augustbering/besc-hw/design/BLDC_4.kicad_pcb

## KiCad design design/BLDC_4.kicad_pcb (2025-11-01)

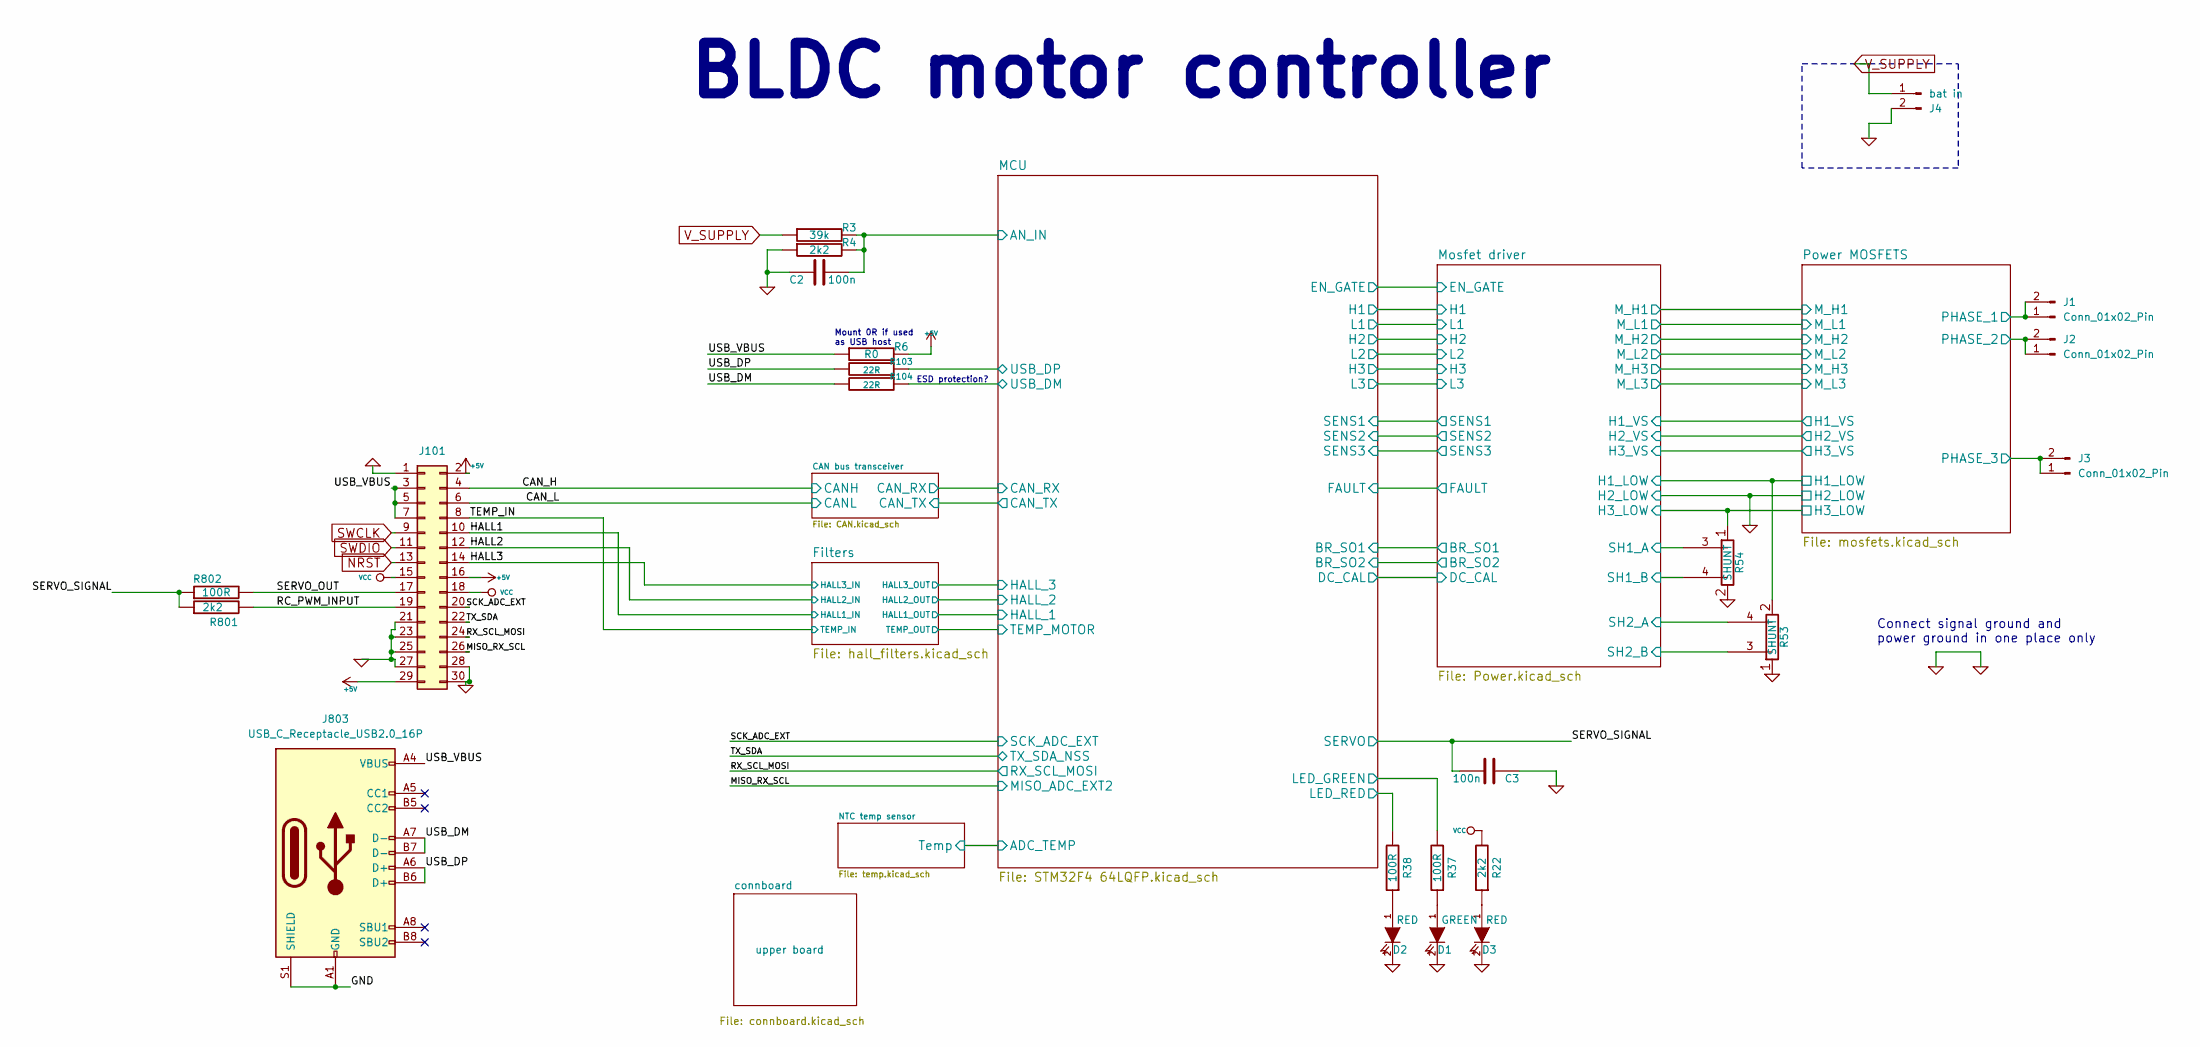
[picture p1: schematic BLDC_4.kicad_sch, BLDC Driver]

Parts:
C2, C3: 100n; SMD-0603_c
D1: GREEN; LED-0603; JLCPCB C19273151
D2, D3: RED; LED-0603
J1, J2, J3: Conn_01x02_Pin; AMASS_XT60-F_1x02_P7.20mm_Vertical; JLCPCB C98734
J4: bat in; xt-90 vertical; JLCPCB C3040688
J101: Conn_02x16_Odd_Even; PinHeader_2x15_P2.54mm_Vertical; JLCPCB C169817
J803: USB_C_Receptacle_USB2.0_16P; USB_C_Receptacle_GCT_USB4115-03-C; JLCPCB C183608
R3: 39k; SMD-0603_r
R4, R22, R801: 2k2; SMD-0603_r
R6: R0; SMD-0603_r; JLCPCB C21189
R37, R38, R802: 100R; SMD-0603_r
R53, R54: SHUNT; WSLP2726; JLCPCB C500635
R103, R104: 22R; SMD-0603_r

Connections:
+5V: J101.2, J101.16, J101.29, R6.2; also elsewhere on the board
/CAN_H: J101.4; also elsewhere on the board
/CAN_L: J101.6; also elsewhere on the board
/HALL1: J101.10; also elsewhere on the board
/HALL2: J101.12; also elsewhere on the board
/HALL3: J101.14; also elsewhere on the board
/MCU/AN_IN: C2.2, R3.2, R4.2; also elsewhere on the board
/MCU/LED_GREEN: R37.2; also elsewhere on the board
/MCU/LED_RED: R38.2; also elsewhere on the board
/MCU/USB_DM: R104.1; also elsewhere on the board
/MCU/USB_DP: R103.1; also elsewhere on the board
/MISO_RX_SCL: J101.26; also elsewhere on the board
/Mosfet driver/H1_LOW: R53.2; also elsewhere on the board
/Mosfet driver/H1_VS: J1.1, J1.2; also elsewhere on the board
/Mosfet driver/H2_VS: J2.1, J2.2; also elsewhere on the board
/Mosfet driver/H3_LOW: R54.1; also elsewhere on the board
/Mosfet driver/H3_VS: J3.1, J3.2; also elsewhere on the board
/Mosfet driver/SH1_A: R54.3; also elsewhere on the board
/Mosfet driver/SH1_B: R54.4; also elsewhere on the board
/Mosfet driver/SH2_A: R53.4; also elsewhere on the board
/Mosfet driver/SH2_B: R53.3; also elsewhere on the board
/RC_PWM_INPUT: J101.19, R801.2
/RX_SCL_MOSI: J101.24; also elsewhere on the board
/SCK_ADC_EXT: J101.20; also elsewhere on the board
/SERVO_OUT: J101.17, R802.2
/SERVO_SIGNAL: C3.2, R801.1, R802.1; also elsewhere on the board
/TEMP_IN: J101.8; also elsewhere on the board
/TX_SDA: J101.22; also elsewhere on the board
/USB_DM: J803.A7 (D-), J803.B7 (D-), R104.2
/USB_DP: J803.A6 (D+), J803.B6 (D+), R103.2
/USB_VBUS: J101.3, J101.5, J101.7, J803.A4 (VBUS), J803.A9 (VBUS), J803.B4 (VBUS), J803.B9 (VBUS), R6.1
GND: C2.1, C3.1, D1.2 (K), D2.2 (K), D3.2 (K), J4.2, J101.1, J101.21, J101.23, J101.25, J101.27, J101.28, J101.30, J803.A1 (GND), J803.A12 (GND), J803.B1 (GND), J803.B12 (GND), J803.S1 (SHIELD), R4.1, R53.1, R54.2; also elsewhere on the board
NRST: J101.13; also elsewhere on the board
unnamed: D1.1 (A), R37.1
unnamed: D2.1 (A), R38.1
unnamed: D3.1 (A), R22.1
SWCLK: J101.9; also elsewhere on the board
SWDIO: J101.11; also elsewhere on the board
VCC: J101.15, J101.18, R22.2; also elsewhere on the board
V_SUPPLY: J4.1, R3.1; also elsewhere on the board

Notes on the sheet:
BLDC motor controller
ESD protection?
Mount 0R if used as USB host
Connect signal ground and power ground in one place only

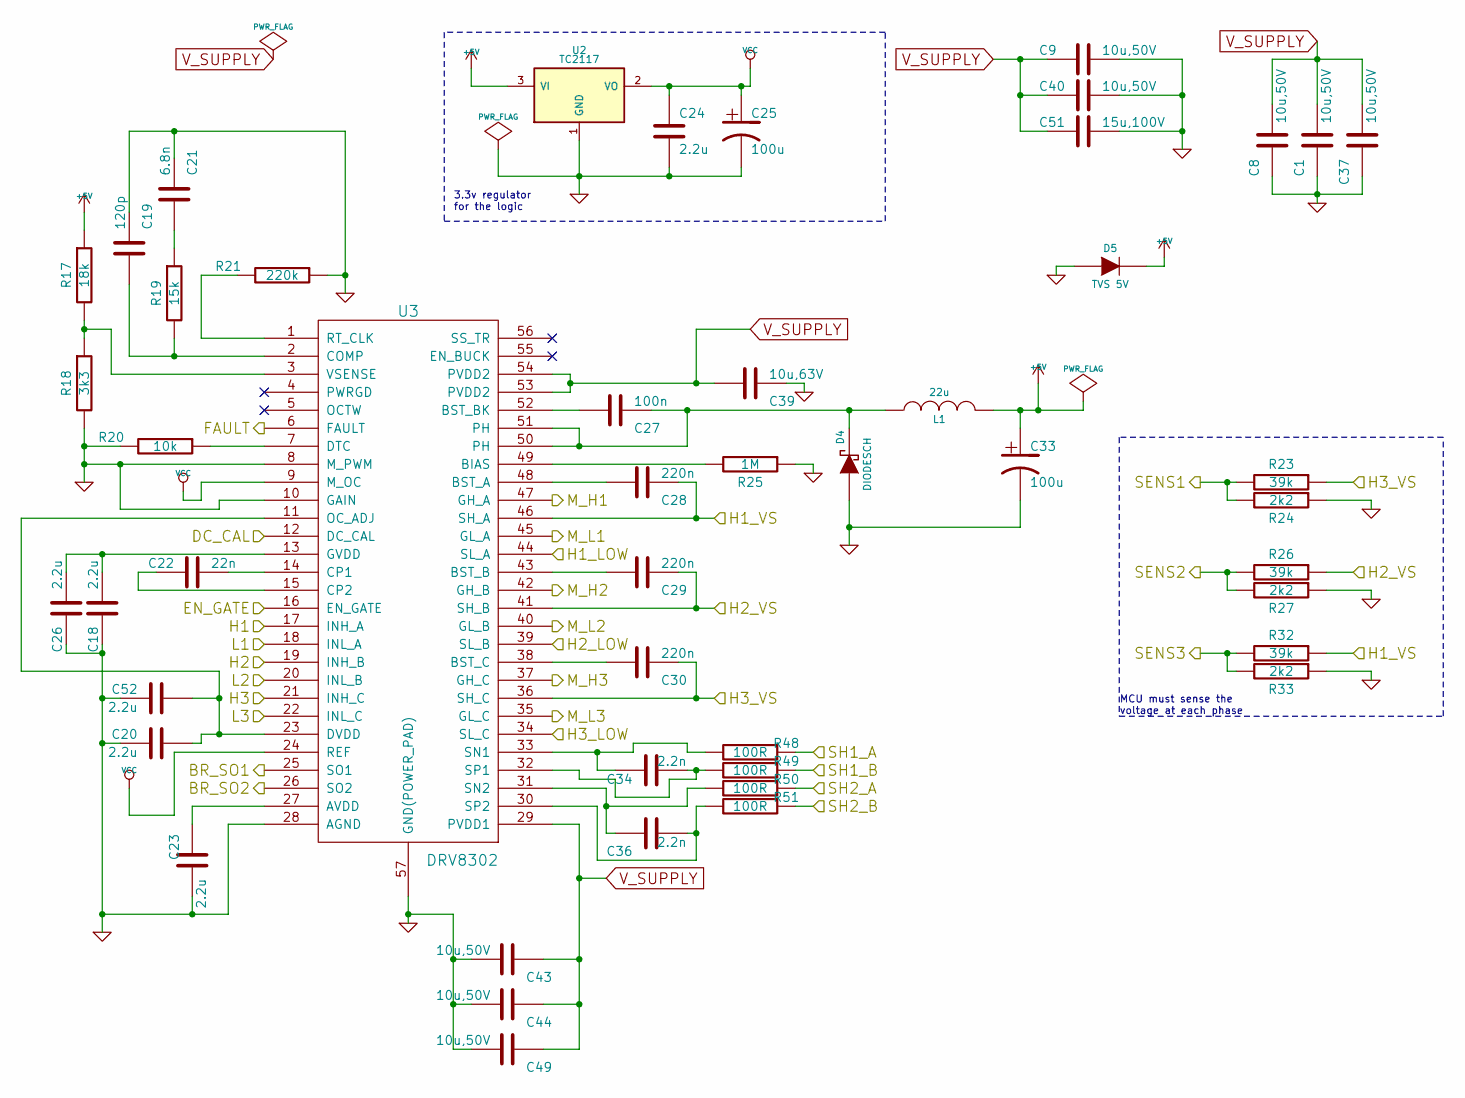
[picture p2: schematic Power.kicad_sch, BLDC Driver 4.11]

Parts:
C1, C8, C9, C37, C40, C43, C44, C49: 10u,50V; SMD-1206; JLCPCB C13585
C18, C20, C23, C24, C26, C52: 2.2u; SMD-0603_c; JLCPCB C23630
C19: 120p; SMD-0603_c
C21: 6.8n; SMD-0603_c
C22: 22n; SMD-0603_c
C25, C33: 100u; c_tant_B; JLCPCB C116740
C27: 100n; SMD-0603_c
C28, C29, C30: 220n; SMD-0603_c
C34, C36: 2.2n; SMD-0603_c
C39: 10u,63V; SMD-1206
C51: 15u,100V; c_2220; JLCPCB C5795620
D4: DIODESCH; SMA_Handsoldering; JLCPCB C6807782
D5: TVS 5V; do214ac; JLCPCB C2760868
L1: 22u; inductor_smd_8x5mm; JLCPCB C139488
R17: 18k; SMD-0603_r
R18: 3k3; SMD-0603_r
R19: 15k; SMD-0603_r
R20: 10k; SMD-0603_r
R21: 220k; SMD-0603_r
R23, R26, R32: 39k; SMD-0603_r
R24, R27, R33: 2k2; SMD-0603_r
R25: 1M; SMD-0603_r
R48, R49, R50, R51: 100R; SMD-0603_r
U2: TC2117; SOT-223; JLCPCB C98655
U3: DRV8302; TSSOP-56-PP; JLCPCB C79740

Connections:
+5V: C33.1, D5.2 (K), L1.2, R17.1, U2.3 (VI); also elsewhere on the board
/MCU/BR_SO1: U3.25 (SO1); also elsewhere on the board
/MCU/BR_SO2: U3.26 (SO2); also elsewhere on the board
/MCU/DC_CAL: U3.12 (DC_CAL); also elsewhere on the board
/MCU/EN_GATE: U3.16 (EN_GATE); also elsewhere on the board
/MCU/FAULT: U3.6 (FAULT); also elsewhere on the board
/MCU/H1: U3.17 (INH_A); also elsewhere on the board
/MCU/H2: U3.19 (INH_B); also elsewhere on the board
/MCU/H3: U3.21 (INH_C); also elsewhere on the board
/MCU/L1: U3.18 (INL_A); also elsewhere on the board
/MCU/L2: U3.20 (INL_B); also elsewhere on the board
/MCU/L3: U3.22 (INL_C); also elsewhere on the board
/MCU/SENS1: R23.2, R24.2; also elsewhere on the board
/MCU/SENS2: R26.2, R27.2; also elsewhere on the board
/MCU/SENS3: R32.2, R33.2; also elsewhere on the board
/Mosfet driver/H1_LOW: U3.44 (SL_A); also elsewhere on the board
/Mosfet driver/H1_VS: C28.1, R32.1, U3.46 (SH_A); also elsewhere on the board
/Mosfet driver/H2_VS: C29.1, R26.1, U3.41 (SH_B); also elsewhere on the board
/Mosfet driver/H3_LOW: U3.34 (SL_C); also elsewhere on the board
/Mosfet driver/H3_VS: C30.1, R23.1, U3.36 (SH_C); also elsewhere on the board
/Mosfet driver/M_H1: U3.47 (GH_A); also elsewhere on the board
/Mosfet driver/M_H2: U3.42 (GH_B); also elsewhere on the board
/Mosfet driver/M_H3: U3.37 (GH_C); also elsewhere on the board
/Mosfet driver/M_L1: U3.45 (GL_A); also elsewhere on the board
/Mosfet driver/M_L2: U3.40 (GL_B); also elsewhere on the board
/Mosfet driver/M_L3: U3.35 (GL_C); also elsewhere on the board
/Mosfet driver/SH1_A: R48.1; also elsewhere on the board
/Mosfet driver/SH1_B: R49.1; also elsewhere on the board
/Mosfet driver/SH2_A: R50.1; also elsewhere on the board
/Mosfet driver/SH2_B: R51.1; also elsewhere on the board
GND: C1.1, C8.1, C9.1, C18.2, C19.1, C20.1, C21.1, C23.1, C24.2, C25.2, C26.2, C33.2, C37.1, C39.1, C40.1, C43.2, C44.2, C49.2, C51.1, C52.1, D4.1 (A), D5.1 (A), R18.2, R20.2, R21.1, R24.1, R25.1, R27.1, R33.1, U2.1 (GND), U3.8 (M_PWM), U3.10 (GAIN), U3.28 (AGND), U3.39 (SL_B), U3.57 (GND(POWER_PAD)); also elsewhere on the board
unnamed: C21.2, R19.1
unnamed: C27.1, D4.2 (K), L1.1, U3.50 (PH), U3.51 (PH)
unnamed: C23.2, U3.27 (AVDD)
unnamed: R25.2, U3.49 (BIAS)
unnamed: C28.2, U3.48 (BST_A)
unnamed: C29.2, U3.43 (BST_B)
unnamed: C27.2, U3.52 (BST_BK)
unnamed: C30.2, U3.38 (BST_C)
unnamed: C19.2, R19.2, U3.2 (COMP)
unnamed: C22.1, U3.14 (CP1)
unnamed: C22.2, U3.15 (CP2)
unnamed: R20.1, U3.7 (DTC)
unnamed: C20.2, C52.2, U3.11 (OC_ADJ), U3.23 (DVDD)
unnamed: C18.1, C26.1, U3.13 (GVDD)
unnamed: R21.2, U3.1 (RT_CLK)
unnamed: C34.1, R48.2, U3.33 (SN1)
unnamed: C36.1, R50.2, U3.31 (SN2)
unnamed: C34.2, R49.2, U3.32 (SP1)
unnamed: C36.2, R51.2, U3.30 (SP2)
unnamed: R17.2, R18.1, U3.3 (VSENSE)
VCC: C24.1, C25.1, U2.2 (VO), U3.9 (M_OC), U3.24 (REF); also elsewhere on the board
V_SUPPLY: C1.2, C8.2, C9.2, C37.2, C39.2, C40.2, C43.1, C44.1, C49.1, C51.2, U3.29 (PVDD1), U3.53 (PVDD2), U3.54 (PVDD2); also elsewhere on the board

Notes on the sheet:
MCU must sense the voltage at each phase
3.3v regulator for the logic

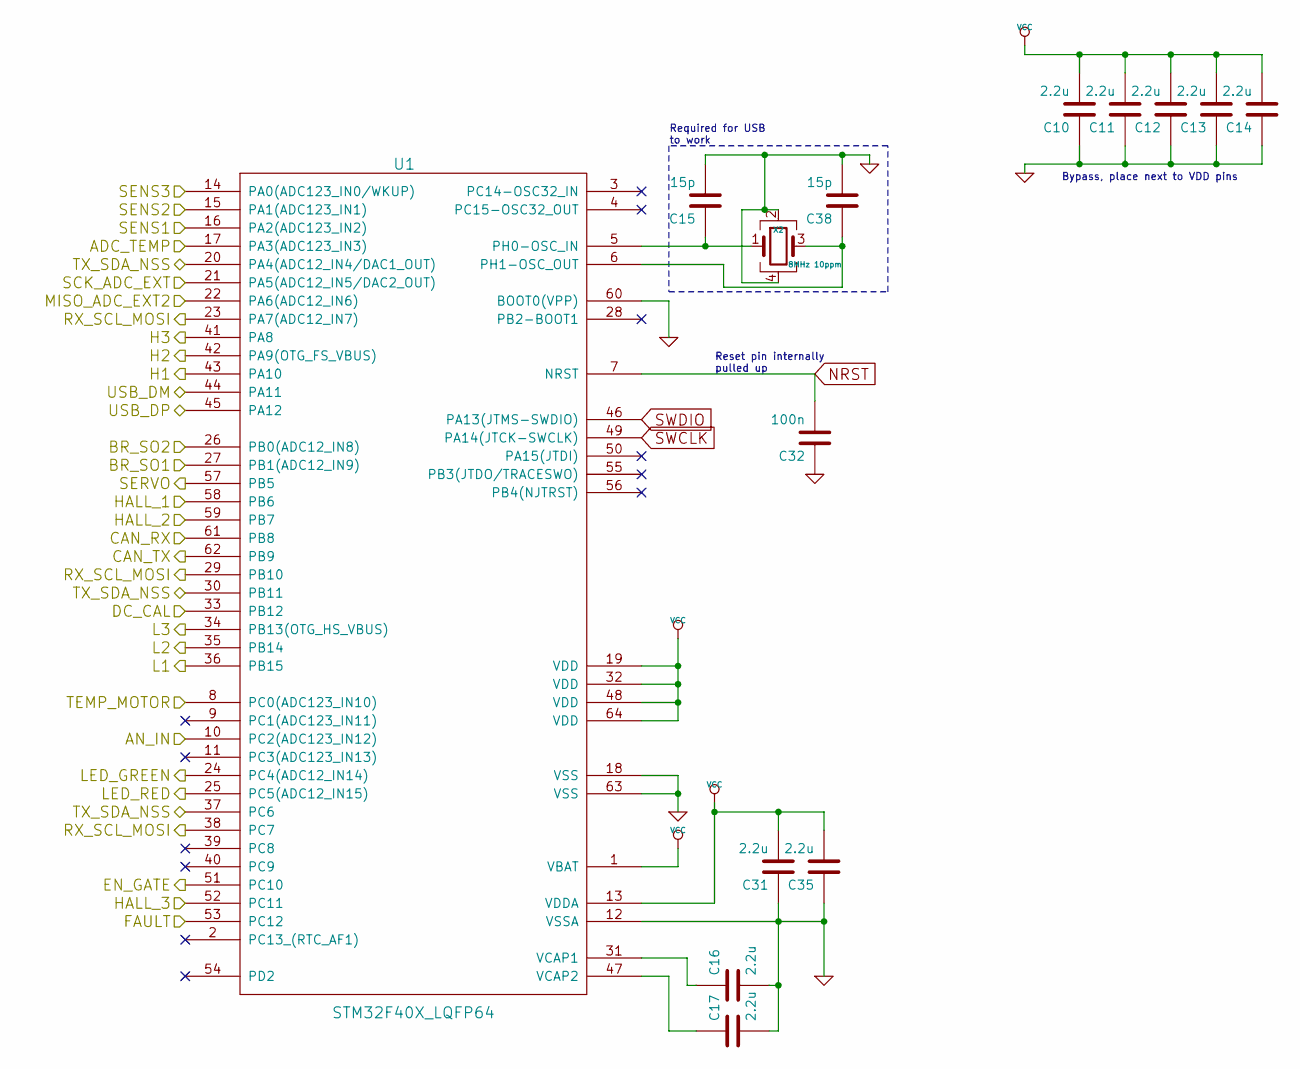
[picture p3: schematic STM32F4 64LQFP.kicad_sch, BLDC Driver 4.11]

Parts:
C10, C11, C12, C13, C14, C16, C17, C31, C35: 2.2u; SMD-0603_c; JLCPCB C23630
C15, C38: 15p; SMD-0603_c
C32: 100n; SMD-0603_c
U1: STM32F40X_LQFP64; lqfp64_pad_mod; JLCPCB C15742
X2: 8MHz 10ppm; Crystal_SMD_3225-4Pin_3.2x2.5mm; JLCPCB C5308002

Connections:
/CAN bus transceiver/CAN_RX: U1.61 (PB8); also elsewhere on the board
/CAN bus transceiver/CAN_TX: U1.62 (PB9); also elsewhere on the board
/Filters/HALL1_OUT: U1.58 (PB6); also elsewhere on the board
/Filters/HALL2_OUT: U1.59 (PB7); also elsewhere on the board
/Filters/HALL3_OUT: U1.52 (PC11); also elsewhere on the board
/MCU/ADC_TEMP: U1.17 (PA3(ADC123_IN3)); also elsewhere on the board
/MCU/AN_IN: U1.10 (PC2(ADC123_IN12)); also elsewhere on the board
/MCU/BR_SO1: U1.27 (PB1(ADC12_IN9)); also elsewhere on the board
/MCU/BR_SO2: U1.26 (PB0(ADC12_IN8)); also elsewhere on the board
/MCU/DC_CAL: U1.33 (PB12); also elsewhere on the board
/MCU/EN_GATE: U1.51 (PC10); also elsewhere on the board
/MCU/FAULT: U1.53 (PC12); also elsewhere on the board
/MCU/H1: U1.43 (PA10); also elsewhere on the board
/MCU/H2: U1.42 (PA9(OTG_FS_VBUS)); also elsewhere on the board
/MCU/H3: U1.41 (PA8); also elsewhere on the board
/MCU/L1: U1.36 (PB15); also elsewhere on the board
/MCU/L2: U1.35 (PB14); also elsewhere on the board
/MCU/L3: U1.34 (PB13(OTG_HS_VBUS)); also elsewhere on the board
/MCU/LED_GREEN: U1.24 (PC4(ADC12_IN14)); also elsewhere on the board
/MCU/LED_RED: U1.25 (PC5(ADC12_IN15)); also elsewhere on the board
/MCU/SENS1: U1.16 (PA2(ADC123_IN2)); also elsewhere on the board
/MCU/SENS2: U1.15 (PA1(ADC123_IN1)); also elsewhere on the board
/MCU/SENS3: U1.14 (PA0(ADC123_IN0/WKUP)); also elsewhere on the board
/MCU/USB_DM: U1.44 (PA11); also elsewhere on the board
/MCU/USB_DP: U1.45 (PA12); also elsewhere on the board
/MISO_RX_SCL: U1.22 (PA6(ADC12_IN6)); also elsewhere on the board
/RX_SCL_MOSI: U1.23 (PA7(ADC12_IN7)), U1.29 (PB10), U1.38 (PC7); also elsewhere on the board
/SCK_ADC_EXT: U1.21 (PA5(ADC12_IN5/DAC2_OUT)); also elsewhere on the board
/SERVO_SIGNAL: U1.57 (PB5); also elsewhere on the board
/TEMP_IN: U1.8 (PC0(ADC123_IN10)); also elsewhere on the board
/TX_SDA: U1.20 (PA4(ADC12_IN4/DAC1_OUT)), U1.30 (PB11), U1.37 (PC6); also elsewhere on the board
GND: C10.1, C11.1, C12.1, C13.1, C14.1, C15.2, C16.2, C17.2, C31.1, C32.1, C35.1, C38.2, U1.12 (VSSA), U1.18 (VSS), U1.60 (BOOT0(VPP)), U1.63 (VSS), X2.2, X2.4; also elsewhere on the board
NRST: C32.2, U1.7 (NRST); also elsewhere on the board
unnamed: C15.1, U1.5 (PH0-OSC_IN), X2.1
unnamed: C38.1, U1.6 (PH1-OSC_OUT), X2.3
unnamed: C16.1, U1.31 (VCAP1)
unnamed: C17.1, U1.47 (VCAP2)
SWCLK: U1.49 (PA14(JTCK-SWCLK)); also elsewhere on the board
SWDIO: U1.46 (PA13(JTMS-SWDIO)); also elsewhere on the board
VCC: C10.2, C11.2, C12.2, C13.2, C14.2, C31.2, C35.2, U1.1 (VBAT), U1.13 (VDDA), U1.19 (VDD), U1.32 (VDD), U1.48 (VDD), U1.64 (VDD); also elsewhere on the board

Notes on the sheet:
Reset pin internally pulled up
Bypass, place next to VDD pins
Required for USB to work

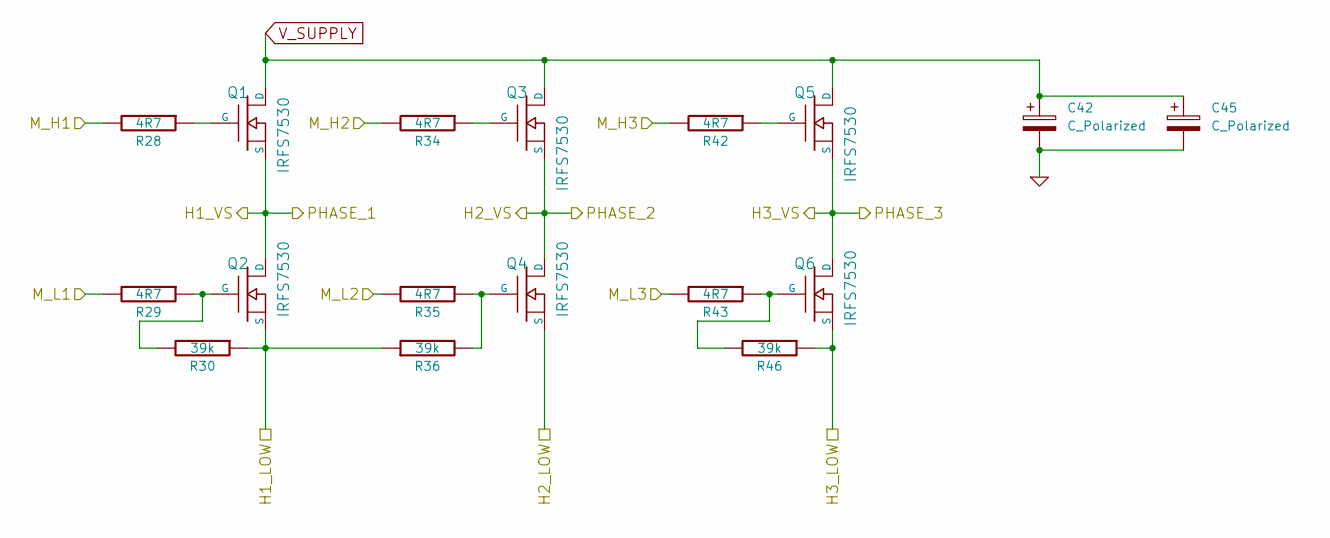
[picture p4: schematic mosfets.kicad_sch, BLDC Driver 4.11]

Parts:
C42, C45: C_Polarized; CP_Radial_D13.0mm_P5.00mm; JLCPCB c106632
Q1, Q2, Q3, Q4, Q5, Q6: IRFS7530; D2PAK-7-GDS; JLCPCB C445669
R28, R29, R34, R35, R42, R43: 4R7; SMD-0603_r
R30, R36, R46: 39k; SMD-0603_r

Connections:
/Mosfet driver/H1_LOW: Q2.S, R30.1, R36.1; also elsewhere on the board
/Mosfet driver/H1_VS: Q1.S, Q2.D; also elsewhere on the board
/Mosfet driver/H2_VS: Q3.S, Q4.D; also elsewhere on the board
/Mosfet driver/H3_LOW: Q6.S, R46.1; also elsewhere on the board
/Mosfet driver/H3_VS: Q5.S, Q6.D; also elsewhere on the board
/Mosfet driver/M_H1: R28.2; also elsewhere on the board
/Mosfet driver/M_H2: R34.2; also elsewhere on the board
/Mosfet driver/M_H3: R42.2; also elsewhere on the board
/Mosfet driver/M_L1: R29.2; also elsewhere on the board
/Mosfet driver/M_L2: R35.2; also elsewhere on the board
/Mosfet driver/M_L3: R43.2; also elsewhere on the board
GND: C42.2, C45.2, Q4.S; also elsewhere on the board
unnamed: Q1.G, R28.1
unnamed: Q2.G, R29.1, R30.2
unnamed: Q3.G, R34.1
unnamed: Q4.G, R35.1, R36.2
unnamed: Q5.G, R42.1
unnamed: Q6.G, R43.1, R46.2
V_SUPPLY: C42.1, C45.1, Q1.D, Q3.D, Q5.D; also elsewhere on the board

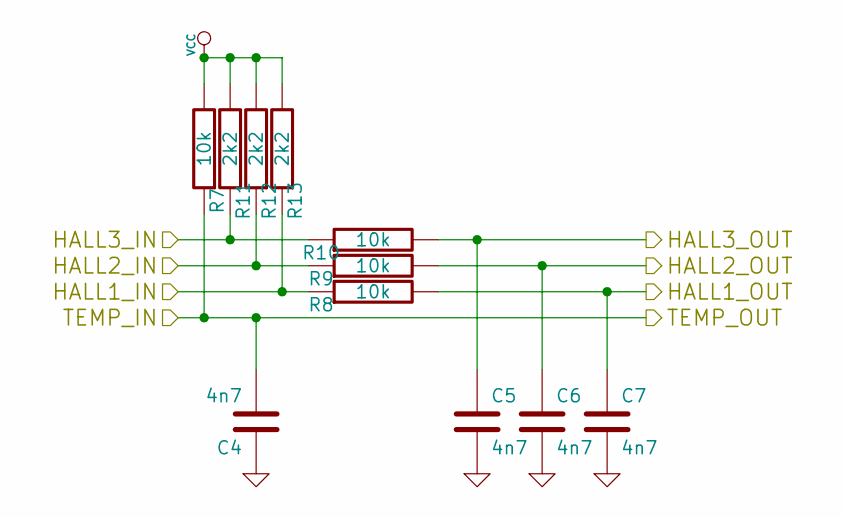
[picture p5: schematic hall_filters.kicad_sch, BLDC Driver 4.11]

Parts:
C4, C5, C6, C7: 4n7; SMD-0603_c; JLCPCB C53987
R7, R8, R9, R10: 10k; SMD-0603_r
R11, R12, R13: 2k2; SMD-0603_r

Connections:
/Filters/HALL1_OUT: C7.1, R8.2; also elsewhere on the board
/Filters/HALL2_OUT: C6.1, R9.2; also elsewhere on the board
/Filters/HALL3_OUT: C5.1, R10.2; also elsewhere on the board
/HALL1: R8.1, R13.1; also elsewhere on the board
/HALL2: R9.1, R12.1; also elsewhere on the board
/HALL3: R10.1, R11.1; also elsewhere on the board
/TEMP_IN: C4.2, R7.1; also elsewhere on the board
GND: C4.1, C5.2, C6.2, C7.2; also elsewhere on the board
VCC: R7.2, R11.2, R12.2, R13.2; also elsewhere on the board


Parts:
C41: 2.2u; SMD-0603_c; JLCPCB C23630
R1: NTC 10k; SMD-0603_r; mpn NCP18XH103F03RB
R2: 10k; SMD-0603_r

Connections:
/MCU/ADC_TEMP: C41.1, R1.2, R2.1; also elsewhere on the board
GND: C41.2, R2.2; also elsewhere on the board
VCC: R1.1; also elsewhere on the board

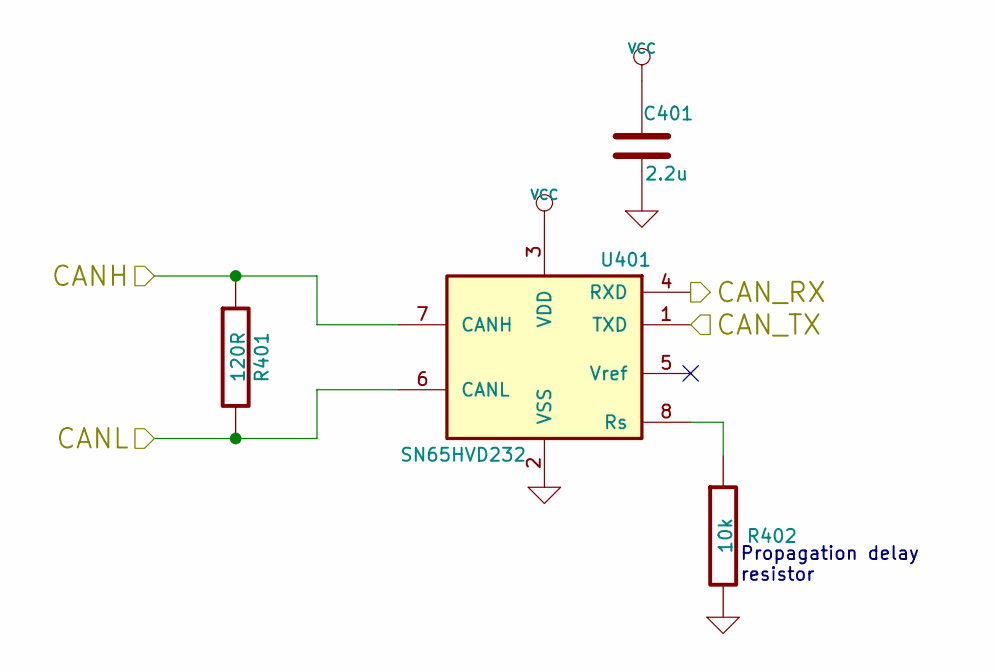
[picture p7: schematic CAN.kicad_sch, BLDC Driver 4.11]

Parts:
C401: 2.2u; SMD-0603_c; JLCPCB C23630
R401: 120R; SMD-0603_r
R402: 10k; SMD-0603_r
U401: SN65HVD232; SOIC-8-W; JLCPCB C30530

Connections:
/CAN bus transceiver/CAN_RX: U401.4 (RXD); also elsewhere on the board
/CAN bus transceiver/CAN_TX: U401.1 (TXD); also elsewhere on the board
/CAN_H: R401.1, U401.7 (CANH); also elsewhere on the board
/CAN_L: R401.2, U401.6 (CANL); also elsewhere on the board
GND: C401.2, R402.2, U401.2 (VSS); also elsewhere on the board
unnamed: R402.1, U401.8 (Rs)
VCC: C401.1, U401.3 (VDD); also elsewhere on the board

Notes on the sheet:
Propagation delay resistor

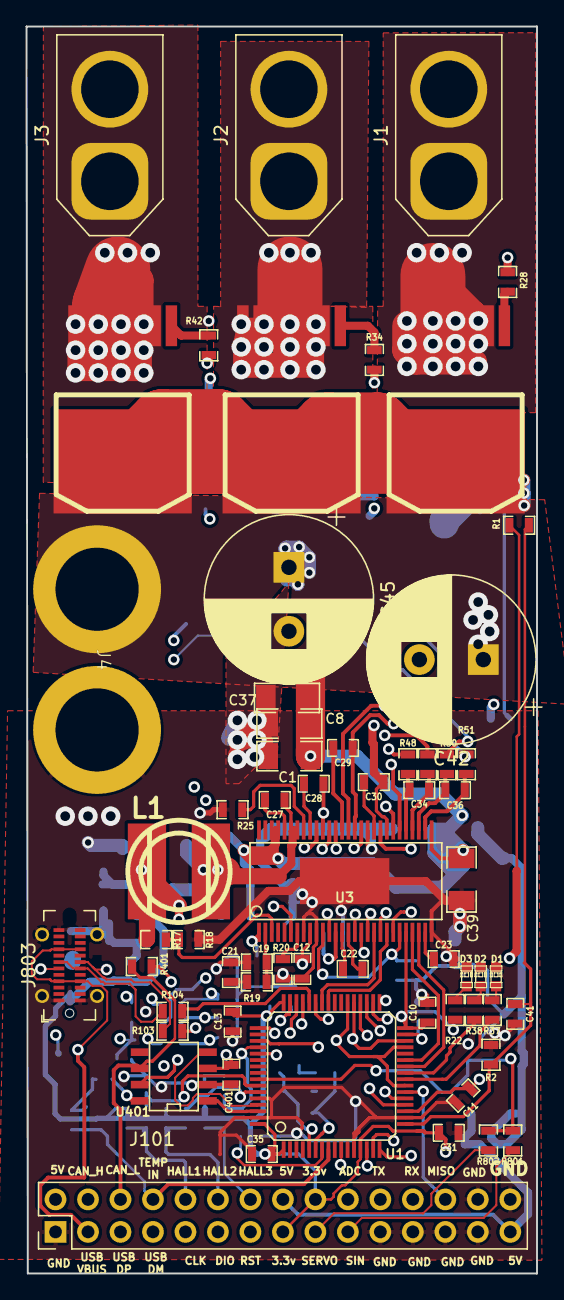
[picture p8: board BLDC_4.kicad_pcb from above]

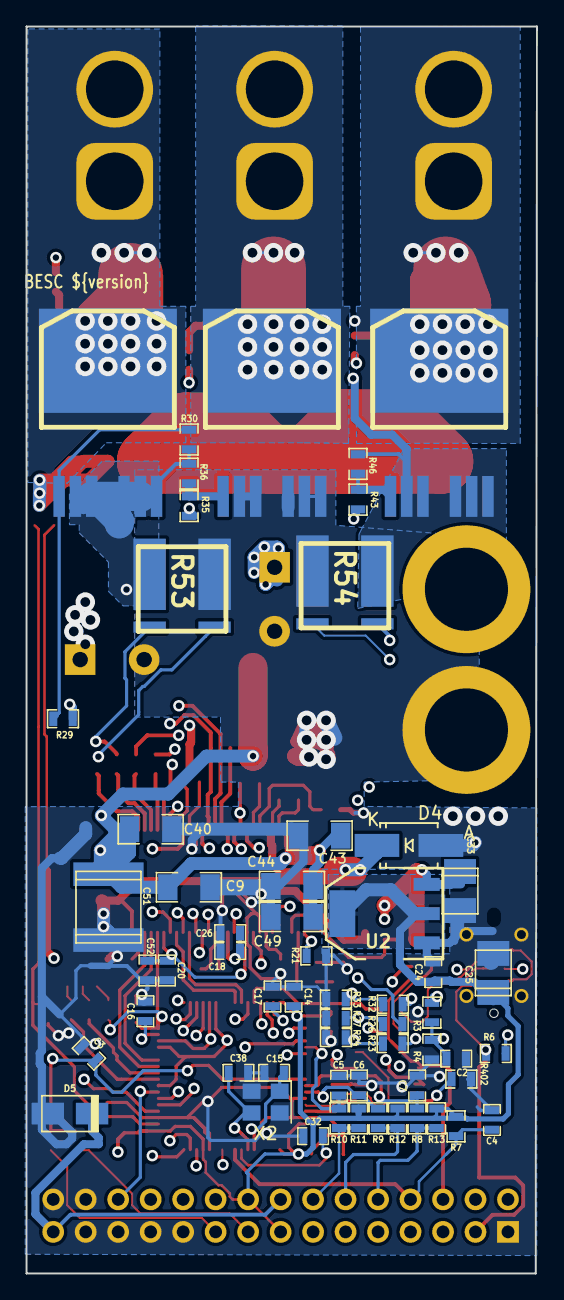
[picture p9: board BLDC_4.kicad_pcb from below]

Board: 4 copper layers, 39.9 x 97.5 mm, 120 parts (58 on the bottom side), 97 nets.
