augustbering/besc-hw/(commit log)

2024-09-02 changed to microusb
    [BLDC_4.kicad_pcb]
2024-09-25 first version ordered, working but USB wrong!
    [BLDC_4-B_Cu.gbl, BLDC_4-B_Mask.gbs, BLDC_4-B_Paste.gbp, BLDC_4-B_SilkS.gbo, BLDC_4-Edge_Cuts.gm1, BLDC_4-F_Cu.gtl, BLDC_4-F_Mask.gts, BLDC_4-F_Paste.gtp]
2024-09-25 fixed usb and changed to new kicad format
    [BLDC_4.kicad_sch, CAN.kicad_sch, Power.kicad_sch, STM32F4 64LQFP.kicad_sch, hall_filters.kicad_sch, mosfets.kicad_sch, temp.kicad_sch]
2024-11-07 extended board include input power caps and holes for wires
    [BLDC_4.kicad_pcb, BLDC_4.kicad_sch, Power.kicad_sch, mosfets.kicad_sch]
2025-09-14 v 4.13 produced by jlcpcb
    Some serious issues with usb connectors facing the caps. Working fine
    otherwise
    [BLDC_4-B_Cu.gbl, BLDC_4-B_Mask.gbs, BLDC_4-B_Paste.gbp, BLDC_4-Edge_Cuts.gm1, BLDC_4-F_Cu.gtl, BLDC_4-F_Mask.gts, BLDC_4-F_Paste.gtp, BLDC_4-NPTH.drl]
2025-10-13 v4.14 Changed power connectors to XT90 and XT60
    [BLDC_4.kicad_pcb, BLDC_4.kicad_sch, Power.kicad_sch]
2025-10-21 moved a cap to not interfere with the usb connector
    [BLDC_4.kicad_pcb]
2025-10-21 removed some gerber files
    [BLDC_4-B_Cu.gbl, BLDC_4-B_Mask.gbs, BLDC_4-B_Paste.gbp, BLDC_4-Edge_Cuts.gm1, BLDC_4-F_Cu.gtl, BLDC_4-F_Mask.gts, BLDC_4-F_Paste.gtp, BLDC_4-NPTH.drl]
2025-10-23 moved the big caps to not interfere with current sense shunts
    [BLDC_4.kicad_pcb]
2025-11-01 moved LEDs to front
    [BLDC_4.kicad_pcb]
